Hanover-CS/HC23-Isaac-Bevis-Senior-Project/code/README.md

## Steps for compiling and running the rolling code gtest suites.

### Prerequisites:
- Must have cmake installed

### Steps:

1. Navigate to HC23-ISAAC-BEVIS-SENIOR-PROJECT/code in terminal

2. Create build directory and go to it 
```bash
mkdir build
cd build
```

3. Compile and build the project 
```bash
cmake ..
make
```

4. run the compiled executable
```bash
./rollingCodeTests
```
