Hanover-CS/HC23-Isaac-Bevis-Senior-Project/Presentation/Poster Board Pages.docx

Prototype Layout (Sender)

- Window Roll-down toggle switch (hold to engage)
- Unlock button (rolls down window when window toggle is held)
- Lock button (rolls up window when window toggle is held)
- 9V Battery connector
- Indicator LED (flashes when signal sends successfully)

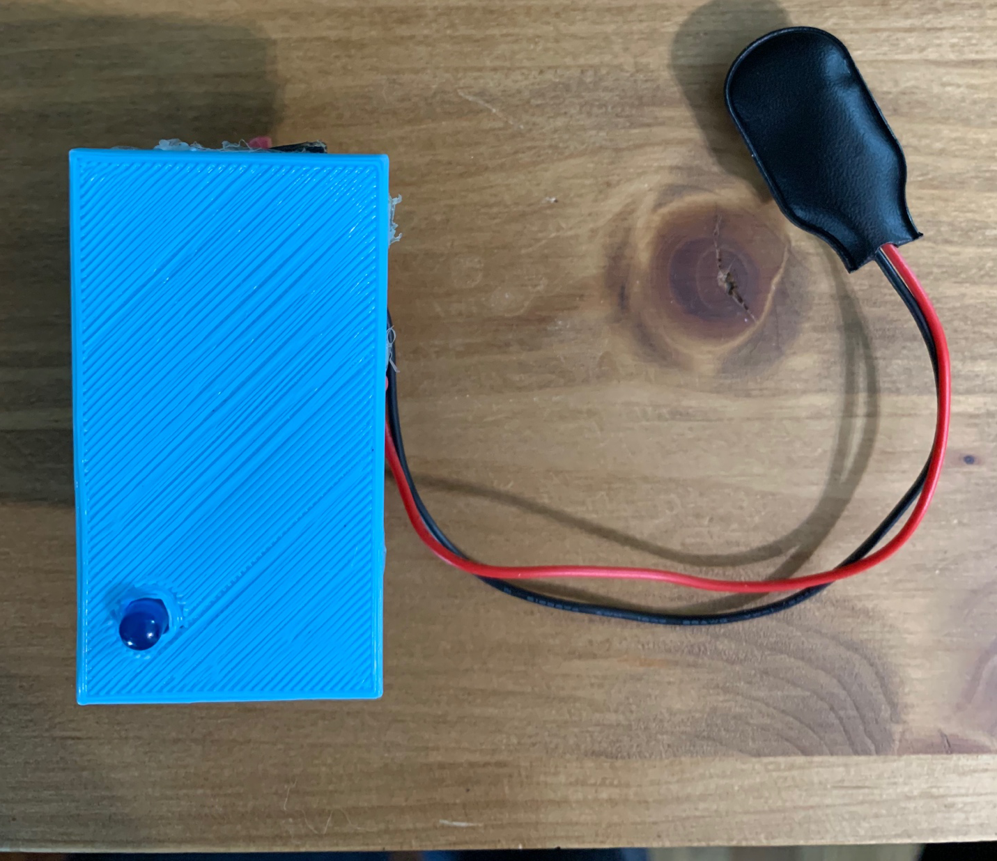
[picture p4: figure]

Prototype Layout (Receiver)

- Window Servo connector (rolls window up and down)
- Lock Servo connector (controls the lock actuator in car door)
- Lock LED (indicates the car is locked, also shows window is being rolled up when window mode is toggled)
- Unlock LED (indicates the car is unlocked, also shows window is being rolled down in window mode)
- Window Mode LED (shows the receiver is in window mode)
- Power Barrel plug (accepts 5 to 12 volts)

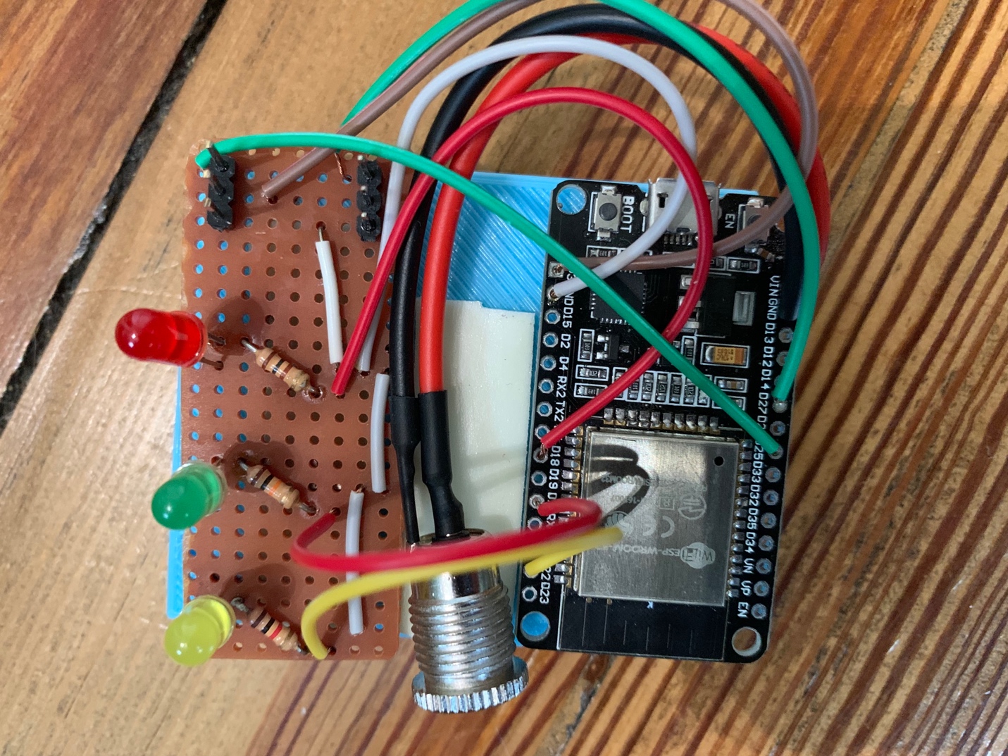
[picture p5: figure]

Sender Wiring Diagram

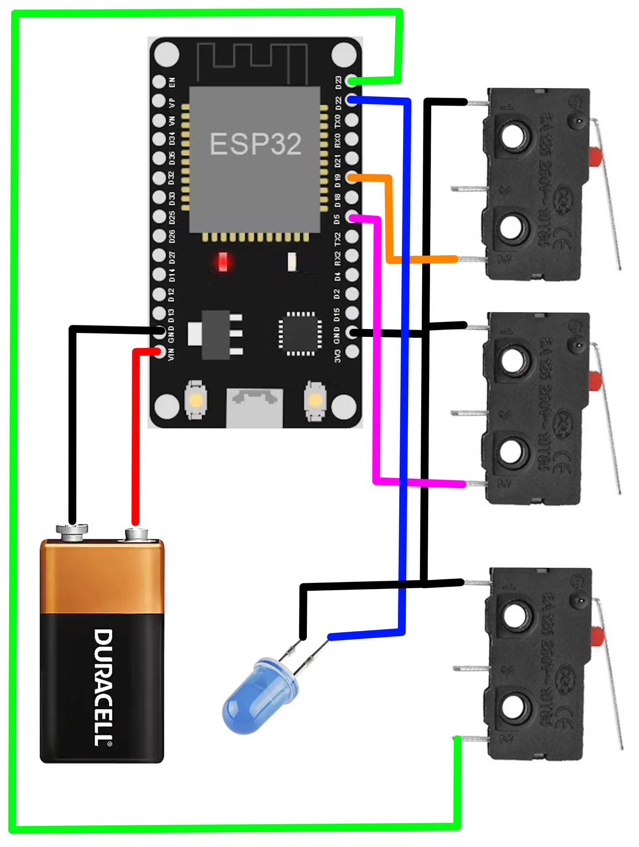
[picture p6: figure]

Receiver Wiring Diagram

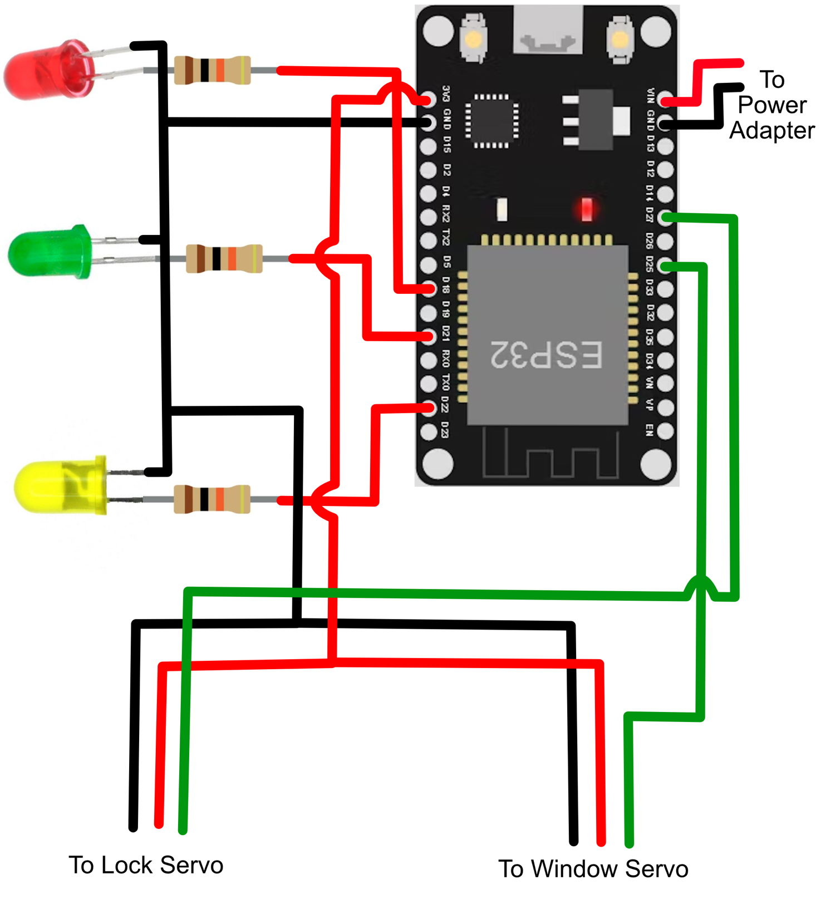
[picture p7: figure]
