Hanover-CS/HC23-Isaac-Bevis-Senior-Project/docs/assets/Reviever Wireing Diagram.png

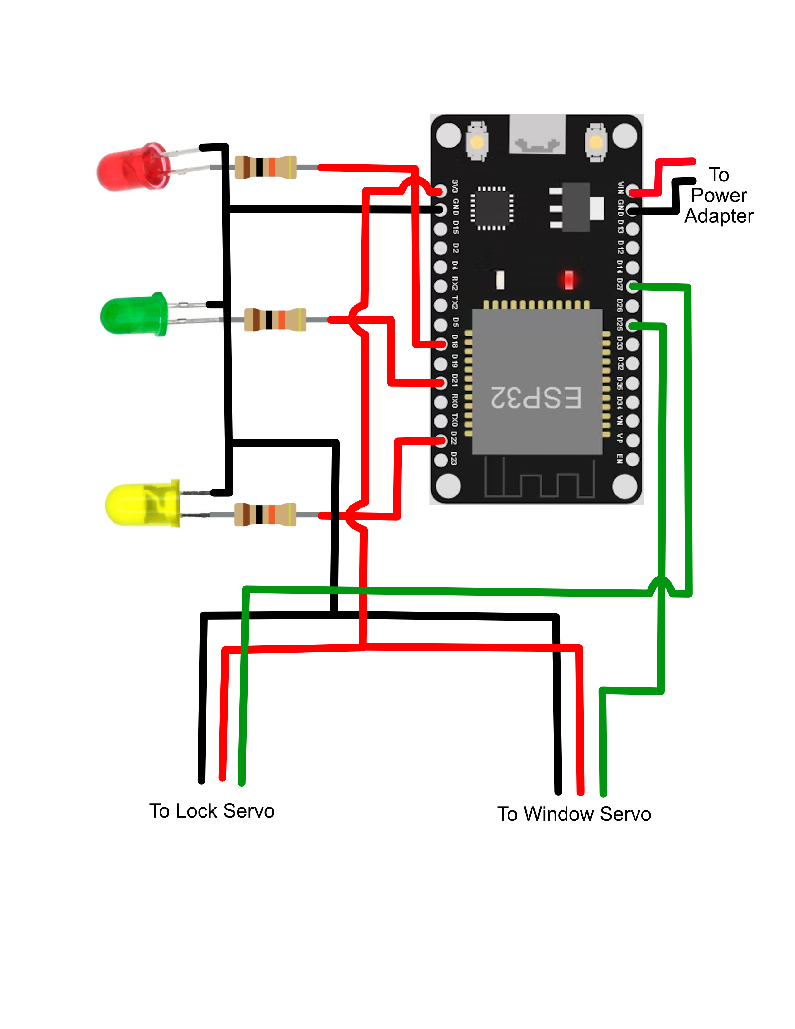
docs/assets/Reviever Wireing Diagram.png
