Hanover-CS/HC23-Isaac-Bevis-Senior-Project/docs/assets/Sender Wireing Diagram.png

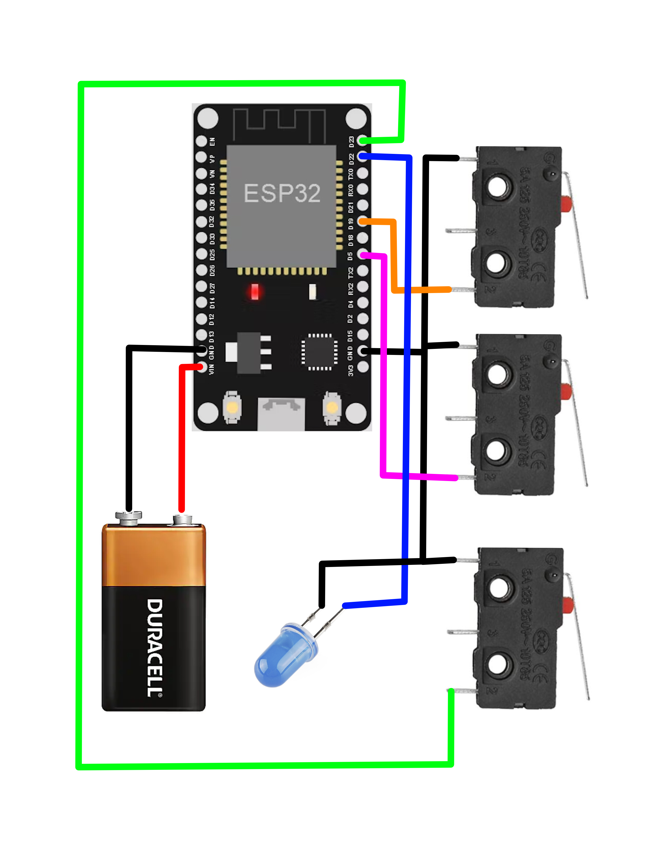
docs/assets/Sender Wireing Diagram.png
