Hanover-CS/HC23-Isaac-Bevis-Senior-Project/CAD/Reciever Housing.FCStd

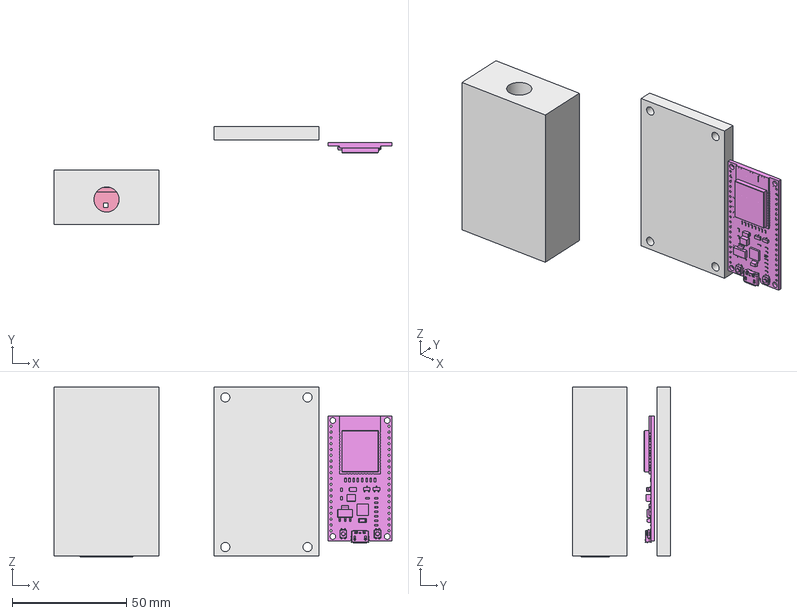
[picture p18: CAD file, 2023-02-06]
CAD/Reciever Housing.FCStd
148.0 x 43.0 x 74.3 mm
Housing Bottom
Housing Top
JST Female 3pin
ESP32_Development_Board
