Hanover-CS/HC23-Isaac-Bevis-Senior-Project/CAD/Remote Housing.FCStd

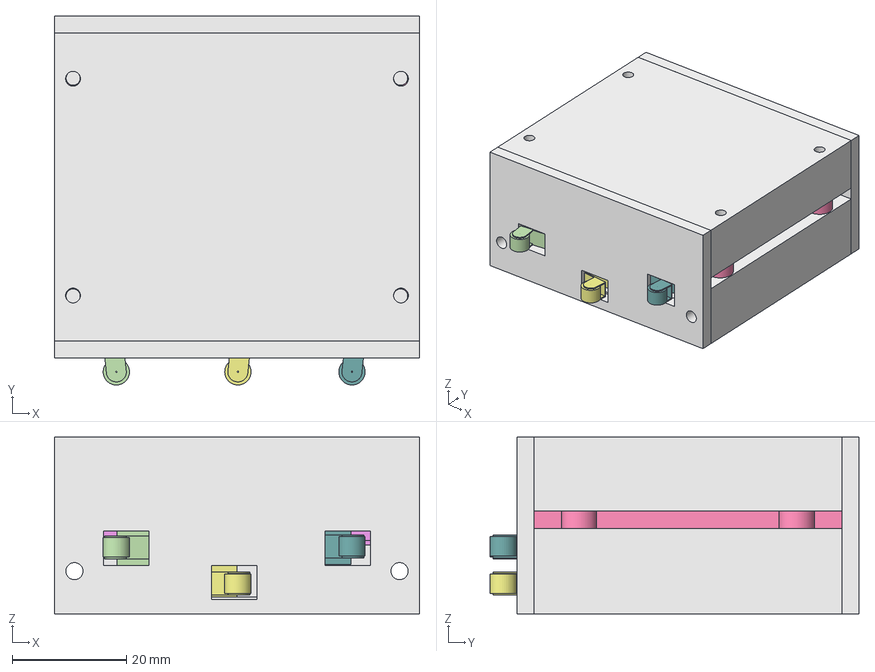
[picture p19: CAD file, 2023-02-06]
CAD/Remote Housing.FCStd
64.0 x 64.7 x 31.0 mm
Battery Cover Bottom
Battery Cover Top
Side1
Side002
Holder
ESP32_Development_Board
Switch
Switch001
Switch002
