Hanover-CS/HC23-Isaac-Bevis-Senior-Project/CAD/Revision 2-Battery Cover.stl

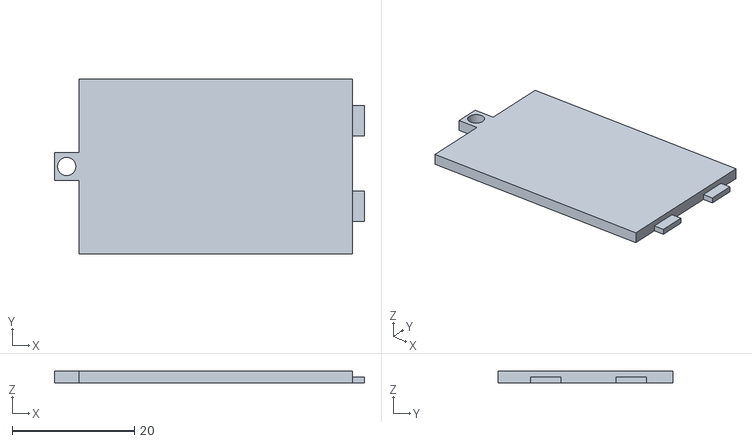
[picture p20: CAD file, 2023-02-06]
CAD/Revision 2-Battery Cover.stl
50.8 x 28.6 x 2.00
