Hanover-CS/HC23-Isaac-Bevis-Senior-Project/CAD/Holder.stl

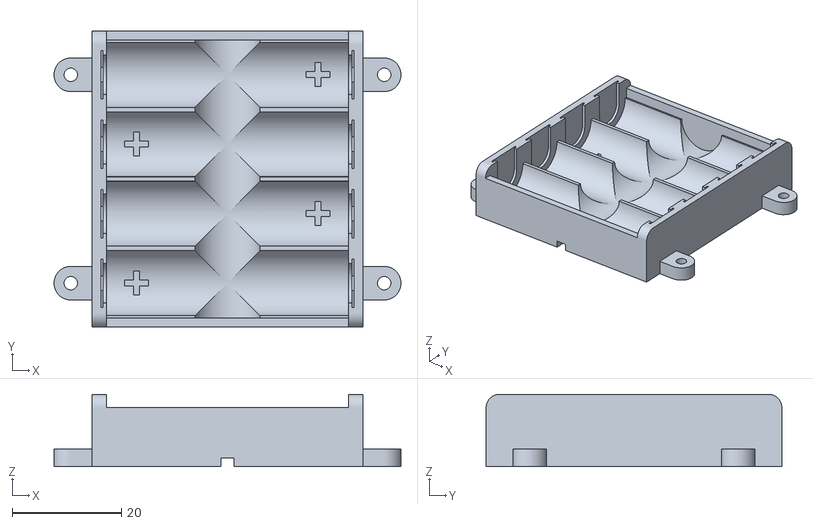
[picture p21: CAD file, 2023-02-06]
CAD/Holder.stl
63.6 x 54.2 x 13.3
