Hanover-CS/HC23-Isaac-Bevis-Senior-Project/CAD/Revision 2-Housing Top.stl

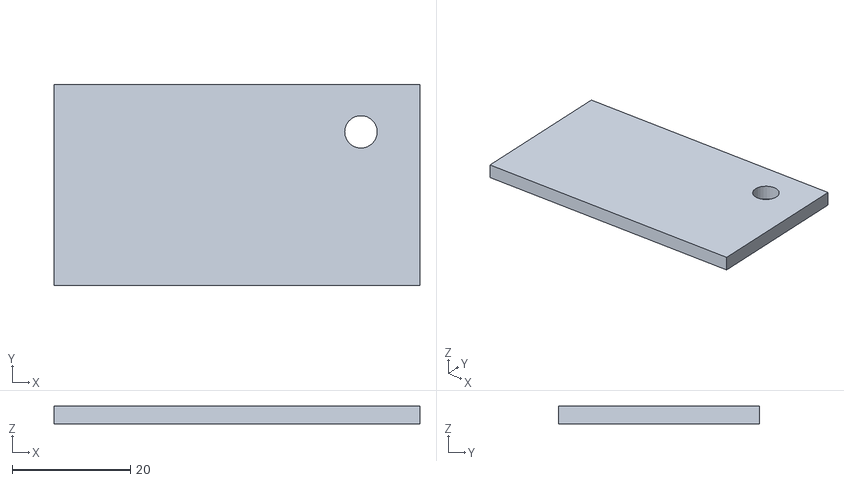
[picture p22: CAD file, 2023-02-06]
CAD/Revision 2-Housing Top.stl
62.0 x 34.0 x 3.00
