Hanover-CS/HC23-Isaac-Bevis-Senior-Project/CAD/Revision 2-Housing Bottom.stl

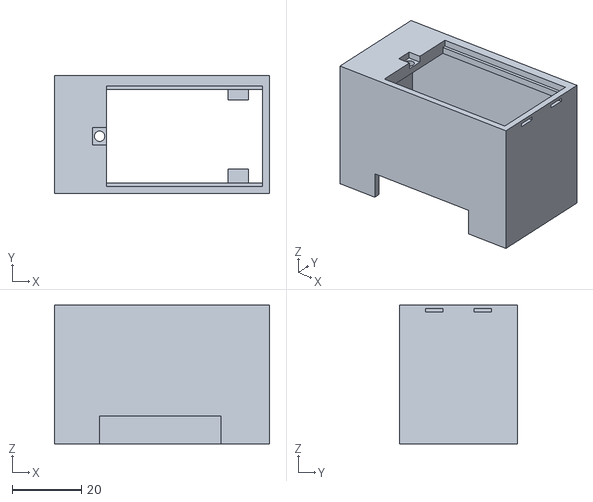
[picture p23: CAD file, 2023-02-06]
CAD/Revision 2-Housing Bottom.stl
62.0 x 34.0 x 40.0
