Hanover-CS/HC23-Isaac-Bevis-Senior-Project/CAD/Remote Housing Revision 2.FCStd

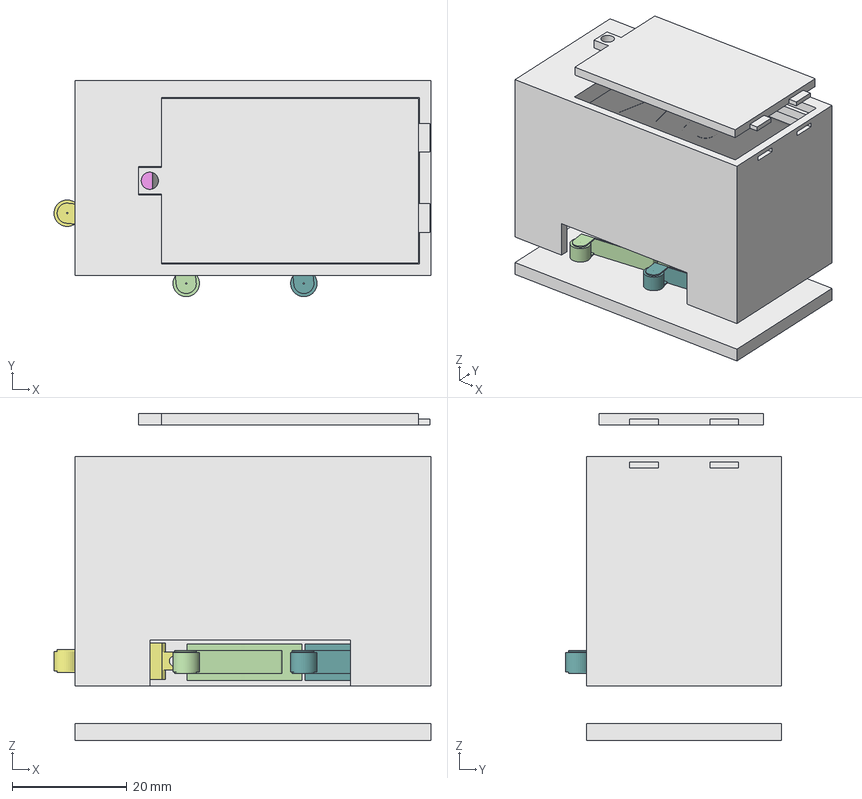
[picture p24: CAD file, 2023-02-06]
CAD/Remote Housing Revision 2.FCStd
65.7 x 37.7 x 57.0 mm
9V Battery
Housing Bottom
Battery Cover
Housing Top
ESP32_Development_Board
Switch
Switch001
Switch002
