Hanover-CS/HC23-Isaac-Bevis-Senior-Project/CAD/JST Male 3pin.stl

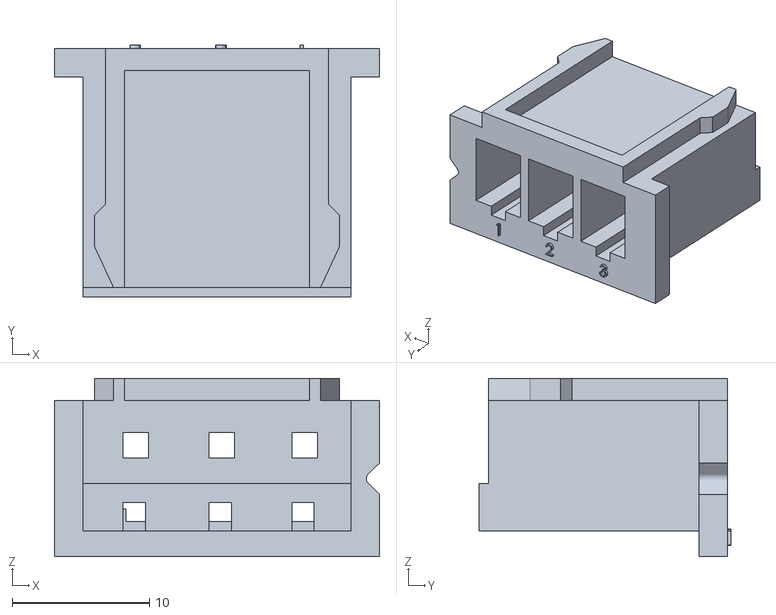
[picture p25: CAD file, 2023-02-03]
CAD/JST Male 3pin.stl
23.7 x 18.4 x 13.0
