Hanover-CS/HC23-Isaac-Bevis-Senior-Project/CAD/JST Female 6pin.stl

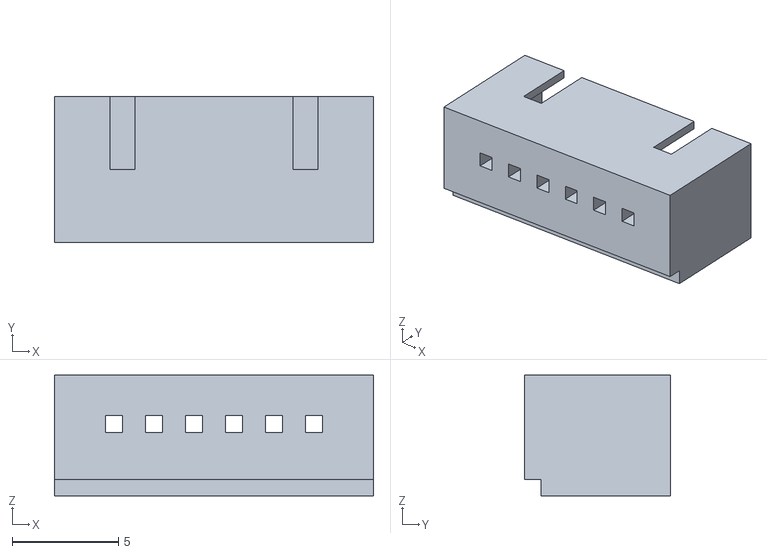
[picture p26: CAD file, 2023-02-03]
CAD/JST Female 6pin.stl
15.0 x 6.86 x 5.68
