Hanover-CS/HC23-Isaac-Bevis-Senior-Project/CAD/JST Female 3pin.stl

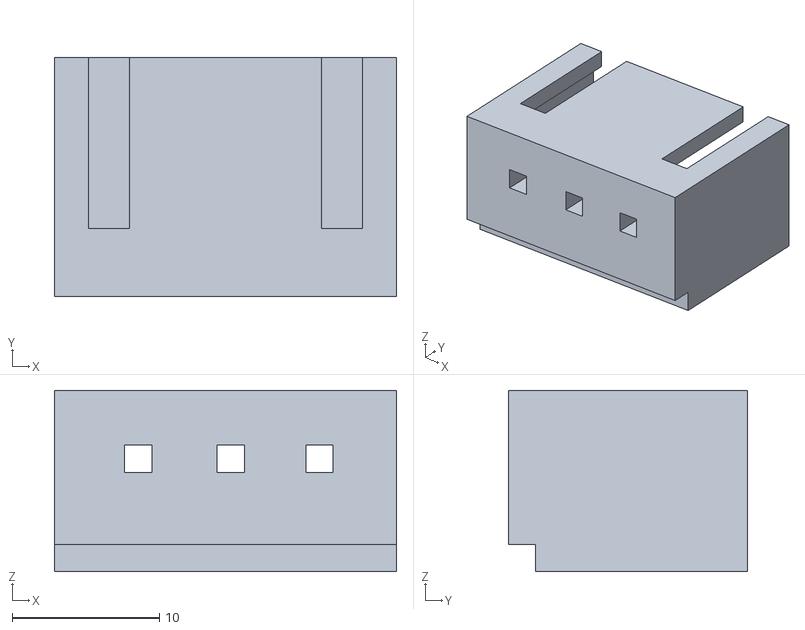
[picture p27: CAD file, 2023-02-03]
CAD/JST Female 3pin.stl
23.3 x 16.3 x 12.3
