Hanover-CS/HC23-Isaac-Bevis-Senior-Project/CAD/Reciever Housing-Housing Bottom.stl

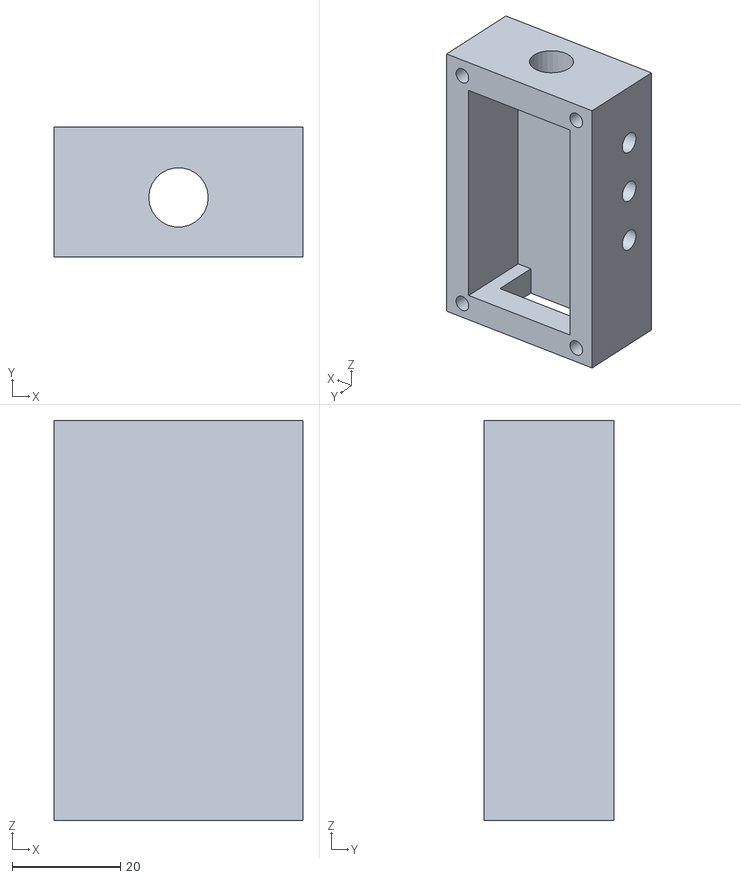
[picture p28: CAD file, 2023-02-03]
CAD/Reciever Housing-Housing Bottom.stl
46.0 x 24.0 x 74.0
