Hanover-CS/HC23-Isaac-Bevis-Senior-Project/CAD/JST Male 6pin.stl

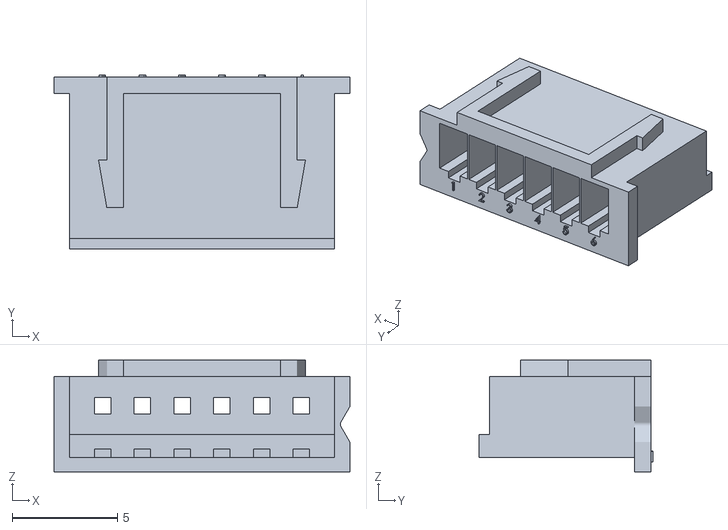
[picture p29: CAD file, 2023-02-03]
CAD/JST Male 6pin.stl
14.0 x 8.25 x 5.31
