Hanover-CS/HC23-Isaac-Bevis-Senior-Project/CAD/Reciever Housing-Housing Top.stl

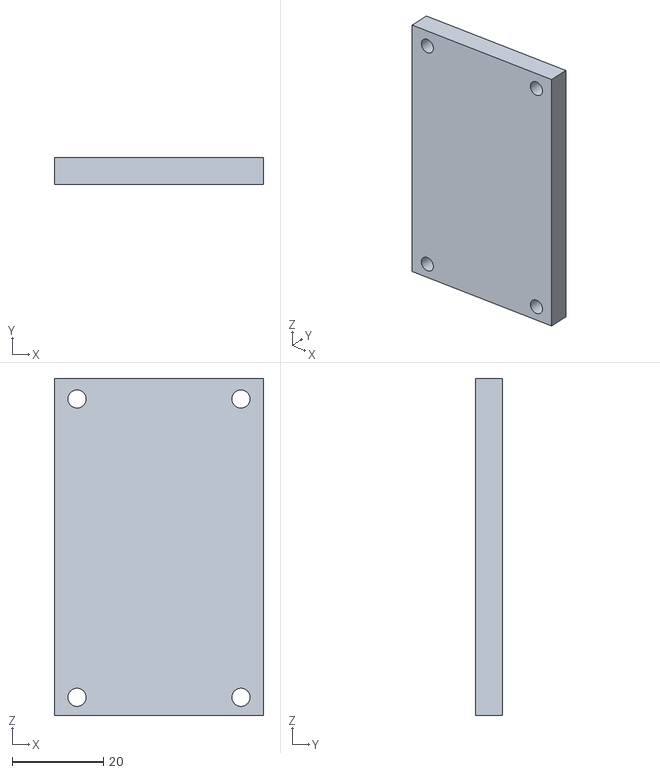
[picture p30: CAD file, 2023-02-03]
CAD/Reciever Housing-Housing Top.stl
46.0 x 6.00 x 74.0
