Hanover-CS/HC23-Isaac-Bevis-Senior-Project/(list of files, cad)

Other CAD files:
CAD/Connector resized.blend
