Hanover-CS/HC23-Isaac-Bevis-Senior-Project/TestPrograms/ESP32/ESP-NOW/ESP-NOW_receiver/ESP-NOW_receiver.ino

#include <esp_now.h>
#include <WiFi.h>


// Structure to receive data
// Must match the sender structure
typedef struct struct_message {
    String a;
    bool b;
} struct_message;

struct_message recvData;

// callback function that will be executed when data is received
void OnDataRecv(const uint8_t * mac, const uint8_t *incomingData, int len) {
  memcpy(&recvData, incomingData, sizeof(recvData));
  Serial.print("Bytes received: ");
  Serial.println(len);
  Serial.print("Message: ");
  Serial.println(recvData.a);
  Serial.print("Bool: ");
  Serial.println(recvData.b);
  Serial.println();

  if (recvData.b){
    digitalWrite(LED_BUILTIN, HIGH);
  }
  else{
    digitalWrite(LED_BUILTIN, LOW);
  }
}

void setup() {
  Serial.begin(115200);
  
  // Set device as a Wi-Fi Station
  WiFi.mode(WIFI_STA);
  pinMode(LED_BUILTIN, OUTPUT);

  // Init ESP-NOW
  if (esp_now_init() != ESP_OK) {
    Serial.println("Error initializing ESP-NOW");
    return;
  }
  
  // Register callback for recieving data
  esp_now_register_recv_cb(OnDataRecv);
}

void loop() {
  // put your main code here, to run repeatedly:

}
