Hanover-CS/HC23-Isaac-Bevis-Senior-Project/(commit log)

2022-09-08 Add links for Pico specific documentation ref #2
2022-09-15 Fix incorrect data on ESP32 power draw close #4
2022-10-27 Add gtest framework ref #12
2022-10-30 fix mistake in calculateMCA.py ref #12
    [RollingCode.h]
2022-11-08 fix documentation in RollingCode.h close #12
    [RollingCode.h]
2022-11-08 Add ESP32 send and receive core function ref #13
2022-11-21 add code for hardware buttons ref #17
2022-11-29 more with buttons ref #17
2022-11-29 add signal LEDs ref #13
2022-11-29 more button testing ref #17
2022-12-01 button debugging close #17
2022-12-01 fix spelling in documentation ref #15
    [ESP32_Reciever.ino]
2023-01-09 Start on reciever housing CAD ref #20
    [Reciever Housing.FCStd]
2023-02-03 Add some 3d CAD designs ref #20
    [Connector resized.blend, Holder.stl, JST Female 3pin.stl, JST Female 6pin.stl, JST Male 3pin.stl, JST Male 6pin.stl, Reciever Housing-Housing Bottom.stl, Reciever Housing-Housing Top.stl]
2023-02-06 Finalize 3d CAD Models close #20
    [Holder.stl, Reciever Housing.FCStd, Remote Housing Revision 2.FCStd, Remote Housing.FCStd, Revision 2-Battery Cover.stl, Revision 2-Housing Bottom.stl, Revision 2-Housing Top.stl]
2023-02-06 Fix Sender for new Hardware close #19
    [ESP32_Sender.ino]
2023-02-07 Fix reciever for new Hardware close #21
    [ESP32_Reciever.ino]
2023-02-07 Fix major bug in window roll-down mechanism
    [ESP32_Sender.ino]
